mariko357/impulse/cad/impulse/symbols/3d/bmp280/Ekran görüntüsü 2021-03-28 230528.jpg

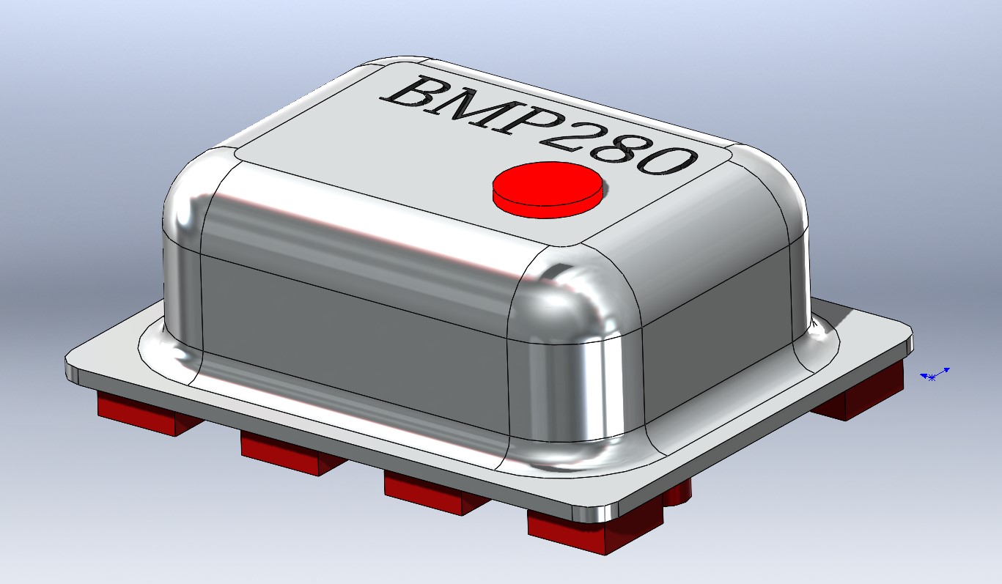
cad/impulse/symbols/3d/bmp280/Ekran görüntüsü 2021-03-28 230528.jpg
