mariko357/impulse/cad/impulse/symbols/3d/bmp280/BMP.jpg

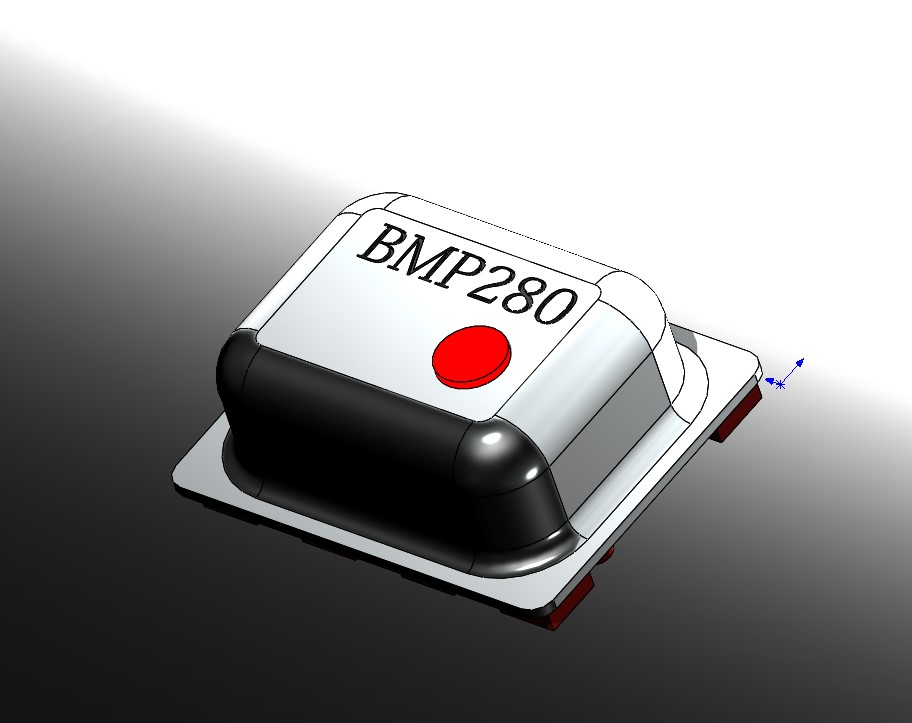
cad/impulse/symbols/3d/bmp280/BMP.jpg
