mariko357/impulse/readme.md

# Impulse
***
## Todo:
- [ ] Create a propper readme, I guess.
