mariko357/impulse/cad/impulse/symbols/3d/bmp280/BMP 280.STEP

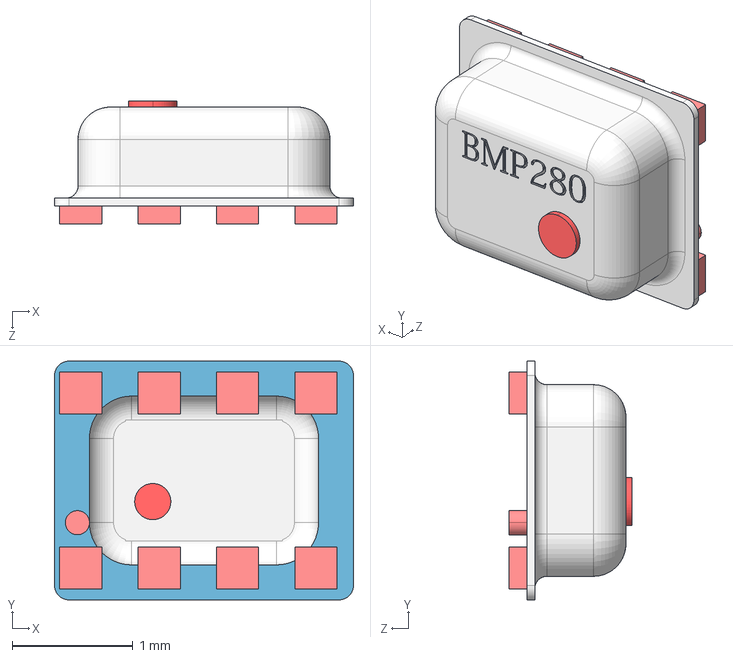
[picture p3: CAD file, 2023-07-16]
cad/impulse/symbols/3d/bmp280/BMP 280.STEP
2.48 x 1.98 x 1.02 mm
