mariko357/impulse/cad/impulse/symbols/bmi270/BMI270.step

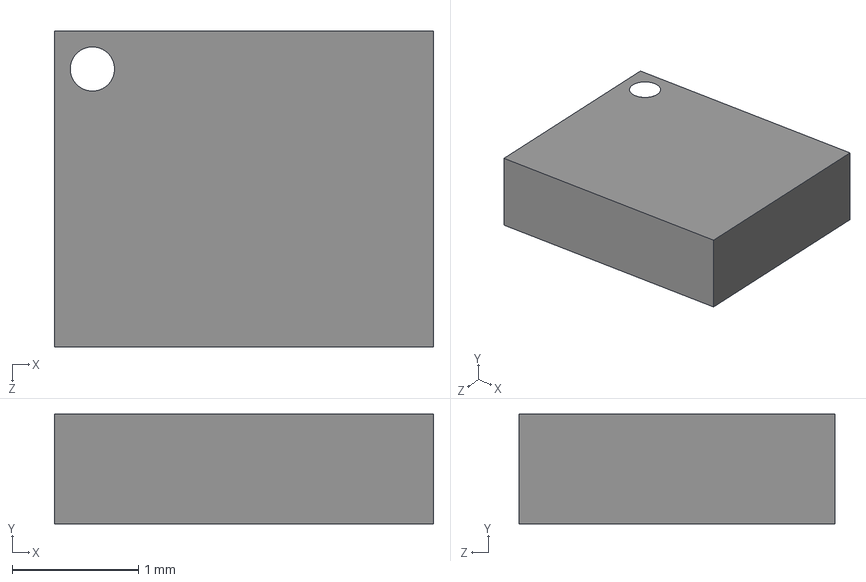
[picture p5: CAD file, 2023-05-13]
cad/impulse/symbols/bmi270/BMI270.step
3.00 x 0.87 x 2.50 mm
