mariko357/impulse/cad/impulse/impulse.kicad_pcb

## KiCad design cad/impulse/impulse.kicad_pcb (2023-07-16)

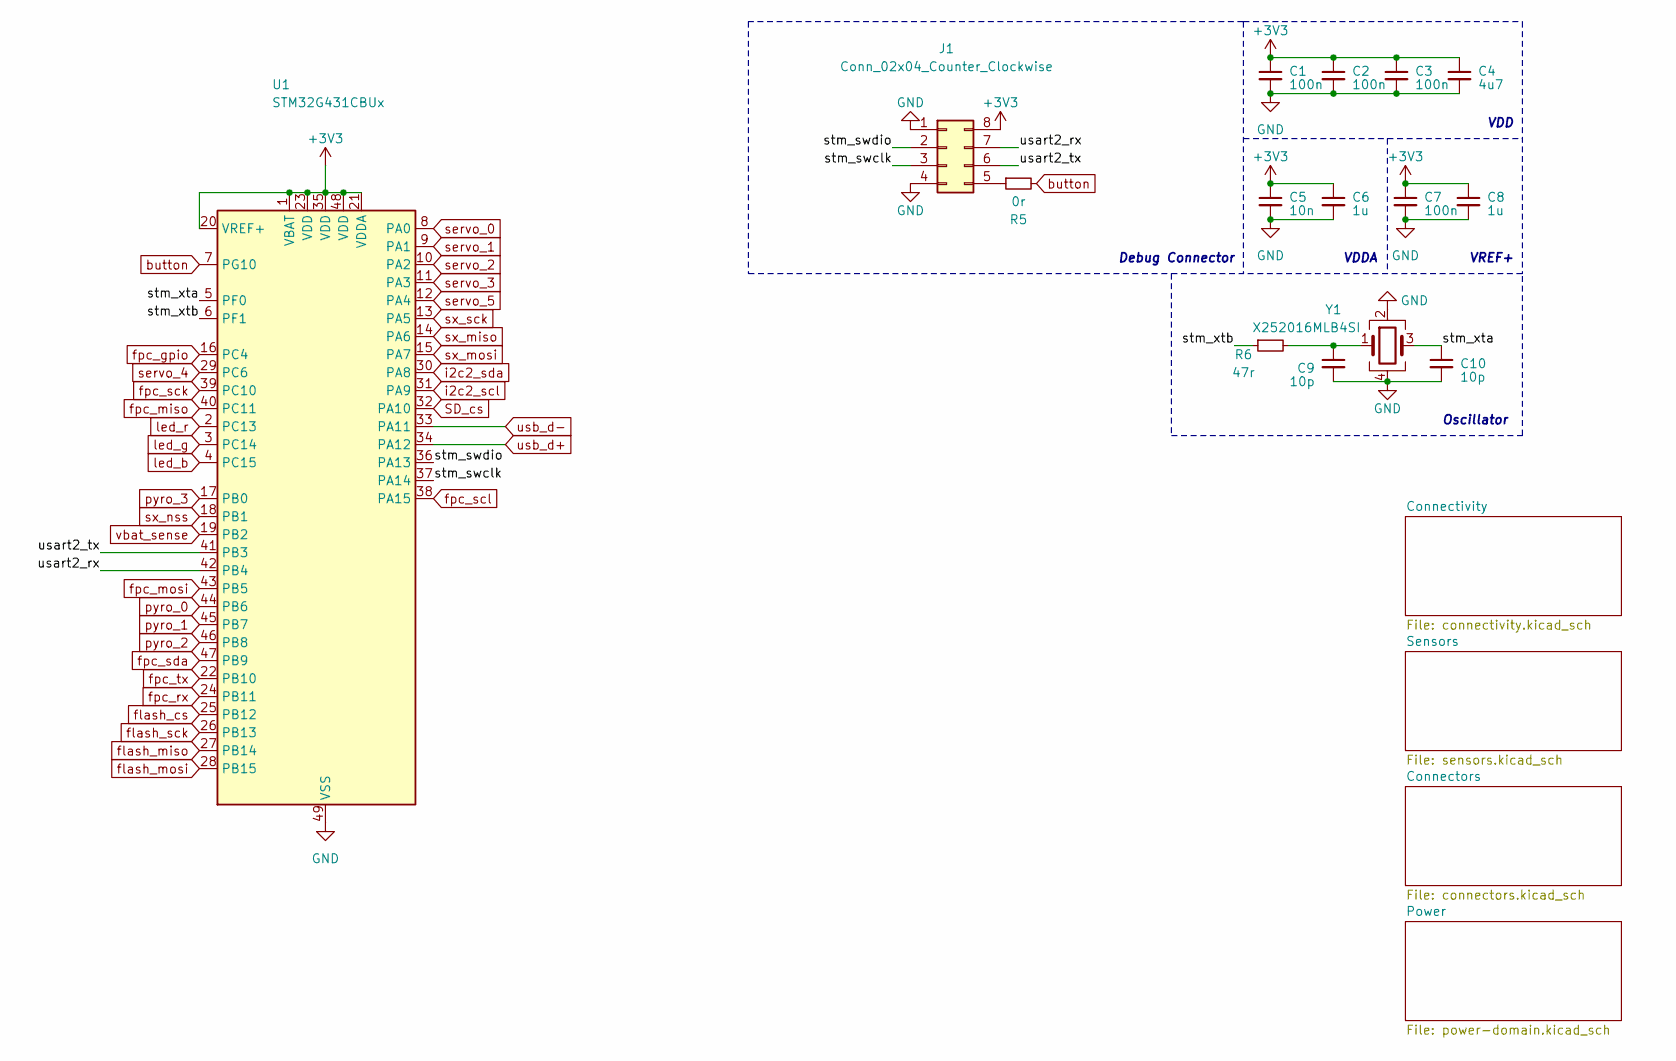
[picture p6: schematic impulse.kicad_sch, MCU]

Parts:
C1, C2, C3, C7: 100n; C_0402_1005Metric; lcsc C1525
C4: 4u7; C_0603_1608Metric; lcsc C5360855
C5: 10n; C_0603_1608Metric; lcsc C525264
C6, C8: 1u; C_0603_1608Metric; lcsc C167338
C9, C10: 10p; C_0402_1005Metric; lcsc C1545
J1: Conn_02x04_Counter_Clockwise; PinHeader_2x04_P1.27mm_Vertical_SMD; lcsc C2685182
R5: 0r; R_0402_1005Metric; lcsc C21376
R6: 47r; R_0402_1005Metric; lcsc C2906947
U1: STM32G431CBUx; QFN-48-1EP_7x7mm_P0.5mm_EP5.6x5.6mm; lcsc C529356
Y1: X252016MLB4SI; Crystal_SMD_2520-4Pin_2.5x2.0mm; lcsc C784073

Connections:
+3V3: C1.1, C2.1, C3.1, C4.1, C5.1, C6.1, C7.1, C8.1, J1.8, U1.1 (VBAT), U1.20 (VREF+), U1.21 (VDDA), U1.23 (VDD), U1.35 (VDD), U1.48 (VDD); also elsewhere on the board
/stm_swclk: J1.3, U1.37 (PA14)
/stm_swdio: J1.2, U1.36 (PA13)
/stm_xta: C10.1, U1.5 (PF0), Y1.3
/stm_xtb: R6.1, U1.6 (PF1)
/usart2_rx: J1.7, U1.42 (PB4)
/usart2_tx: J1.6, U1.41 (PB3)
GND: C1.2, C2.2, C3.2, C4.2, C5.2, C6.2, C7.2, C8.2, C9.2, C10.2, J1.1, J1.4, U1.49 (VSS), Y1.2, Y1.4; also elsewhere on the board
unnamed: C9.1, R6.2, Y1.1
unnamed: J1.5, R5.1
SD_cs: U1.32 (PA10); also elsewhere on the board
button: R5.2, U1.7 (PG10); also elsewhere on the board
flash_cs: U1.25 (PB12); also elsewhere on the board
flash_miso: U1.27 (PB14); also elsewhere on the board
flash_mosi: U1.28 (PB15); also elsewhere on the board
flash_sck: U1.26 (PB13); also elsewhere on the board
fpc_gpio: U1.16 (PC4); also elsewhere on the board
fpc_miso: U1.40 (PC11); also elsewhere on the board
fpc_mosi: U1.43 (PB5); also elsewhere on the board
fpc_rx: U1.24 (PB11); also elsewhere on the board
fpc_sck: U1.39 (PC10); also elsewhere on the board
fpc_tx: U1.22 (PB10); also elsewhere on the board
led_b: U1.4 (PC15); also elsewhere on the board
led_g: U1.3 (PC14); also elsewhere on the board
led_r: U1.2 (PC13); also elsewhere on the board
pyro_0: U1.44 (PB6); also elsewhere on the board
pyro_1: U1.45 (PB7); also elsewhere on the board
pyro_2: U1.46 (PB8); also elsewhere on the board
pyro_3: U1.17 (PB0); also elsewhere on the board
servo_0: U1.8 (PA0); also elsewhere on the board
servo_1: U1.9 (PA1); also elsewhere on the board
servo_2: U1.10 (PA2); also elsewhere on the board
servo_3: U1.11 (PA3); also elsewhere on the board
servo_4: U1.29 (PC6); also elsewhere on the board
servo_5: U1.12 (PA4); also elsewhere on the board
sx_miso: U1.14 (PA6); also elsewhere on the board
sx_mosi: U1.15 (PA7); also elsewhere on the board
sx_nss: U1.18 (PB1); also elsewhere on the board
sx_sck: U1.13 (PA5); also elsewhere on the board
usb_d+: U1.34 (PA12); also elsewhere on the board
usb_d-: U1.33 (PA11); also elsewhere on the board
vbat_sense: U1.19 (PB2); also elsewhere on the board

Notes on the sheet:
VREF+
VDD
Oscillator
Debug Connector
VDDA

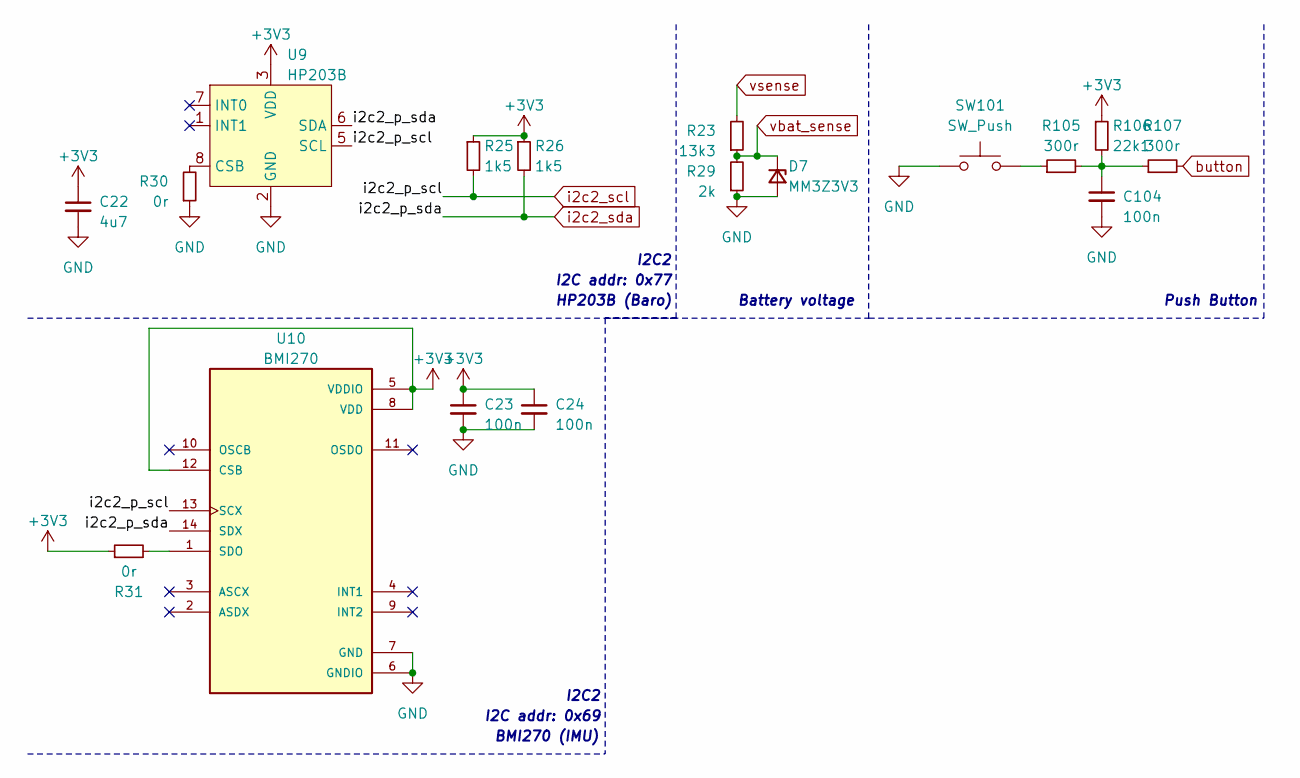
[picture p7: schematic sensors.kicad_sch]

Parts:
C22: 4u7; C_0603_1608Metric; lcsc C5360855
C23, C24, C104: 100n; C_0402_1005Metric; lcsc C1525
D7: MM3Z3V3; D_SOD-323; lcsc C2978809
R23: 13k3; R_0402_1005Metric; lcsc C3015832
R25, R26: 1k5; R_0402_1005Metric; lcsc C3017483
R29: 2k; R_0402_1005Metric; lcsc C3152076
R30, R31: 0r; R_0402_1005Metric; lcsc C21376
R105, R107: 300r; R_0402_1005Metric; lcsc C3017471
R106: 22k1; R_0402_1005Metric; lcsc C5356129
SW101: SW_Push; GT-TC029B-H025-L1N; lcsc C843669
U9: HP203B; QFN-8-P09; lcsc C138665
U10: BMI270; LGA-14_3x2.5mm_P0.5mm_LayoutBorder3x4y; lcsc C2836813

Connections:
+3V3: C22.1, C23.1, C24.1, R25.1, R26.1, R31.1, U9.3 (VDD), U10.5 (VDDIO), U10.8 (VDD), U10.12 (CSB); also elsewhere on the board
GND: C22.2, C23.2, C24.2, D7.2 (A), R29.1, R30.1, U9.2 (GND), U10.6 (GNDIO), U10.7 (GND); also elsewhere on the board
unnamed: R30.2, U9.8 (CSB)
unnamed: R31.2, U10.1 (SDO)
vbat_sense: D7.1 (K), R23.1, R29.2; also elsewhere on the board
vsense: R23.2; also elsewhere on the board

Notes on the sheet:
BMI270 (IMU)
I2C2
I2C addr: 0x69
HP203B (Baro)
Push Button
Battery voltage
I2C addr: 0x77

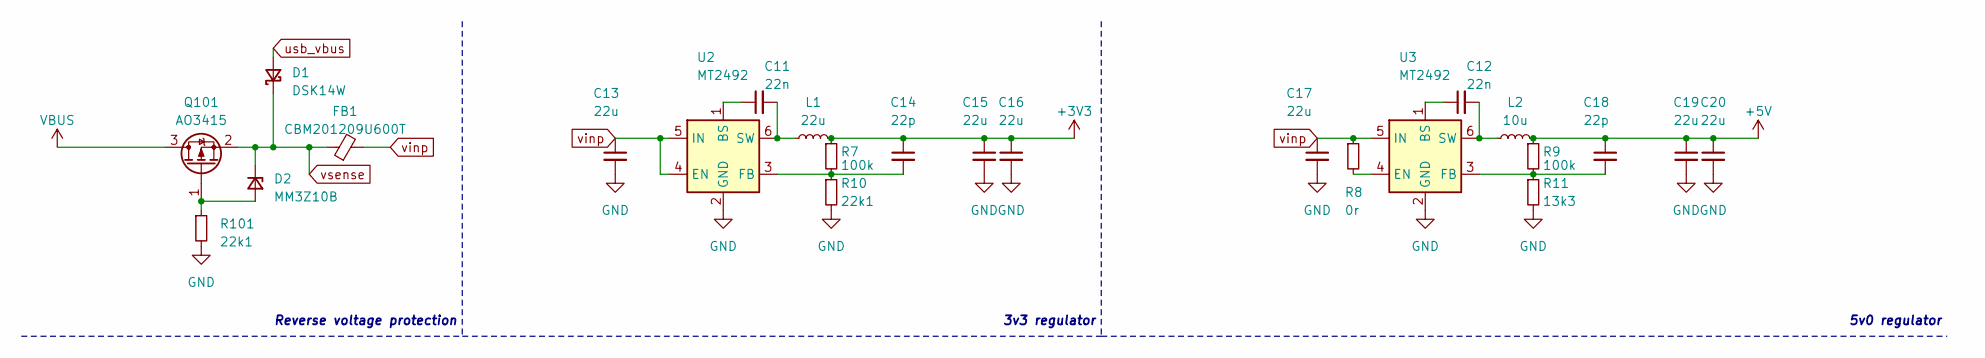
[picture p8: schematic power-domain.kicad_sch, Power]

Parts:
C11, C12: 22n; C_0402_1005Metric; lcsc C5137627
C13, C15, C16, C17, C19, C20: 22u; C_1206_3216Metric; lcsc C2858005
C14, C18: 22p; C_0402_1005Metric; lcsc C5137569
D1: DSK14W; D_SOD-123F; lcsc C3014043
D2: MM3Z10B; D_SOD-323; lcsc C2826565
FB1: CBM201209U600T; R_0805_2012Metric; lcsc C139167
L1: 22u; L_1210_3225Metric; lcsc C223225
L2: 10u; L_Sunlord_MWSA0402S; lcsc C2921170
Q101: AO3415; SOT-23; lcsc C181094
R7, R9: 100k; R_0402_1005Metric; lcsc C3017514
R8: 0r; R_0402_1005Metric; lcsc C21376
R10, R101: 22k1; R_0402_1005Metric; lcsc C5356129
R11: 13k3; R_0402_1005Metric; lcsc C3015832
U2, U3: MT2492; SOT-23-6; lcsc C89358

Connections:
+3V3: C14.1, C15.1, C16.1, L1.2, R7.1; also elsewhere on the board
+5V: C18.1, C19.1, C20.1, L2.2, R9.1; also elsewhere on the board
GND: C13.2, C15.2, C16.2, C17.2, C19.2, C20.2, R10.2, R11.2, U2.2 (GND), U3.2 (GND); also elsewhere on the board
unnamed 24: D2.2 (A); also elsewhere on the board
unnamed: C11.1, U2.1 (BS)
unnamed: C14.2, R7.2, R10.1, U2.3 (FB)
unnamed: C11.2, L1.1, U2.6 (SW)
unnamed: C12.1, U3.1 (BS)
unnamed: R8.2, U3.4 (EN)
unnamed: C18.2, R9.2, R11.1, U3.3 (FB)
unnamed: C12.2, L2.1, U3.6 (SW)
usb_vbus: D1.2 (A); also elsewhere on the board
vinp: C13.1, C17.1, FB1.2, R8.1, U2.4 (EN), U2.5 (IN), U3.5 (IN); also elsewhere on the board
vsense: D1.1 (K), D2.1 (K), FB1.1; also elsewhere on the board

Notes on the sheet:
5v0 regulator
3v3 regulator
Reverse voltage protection

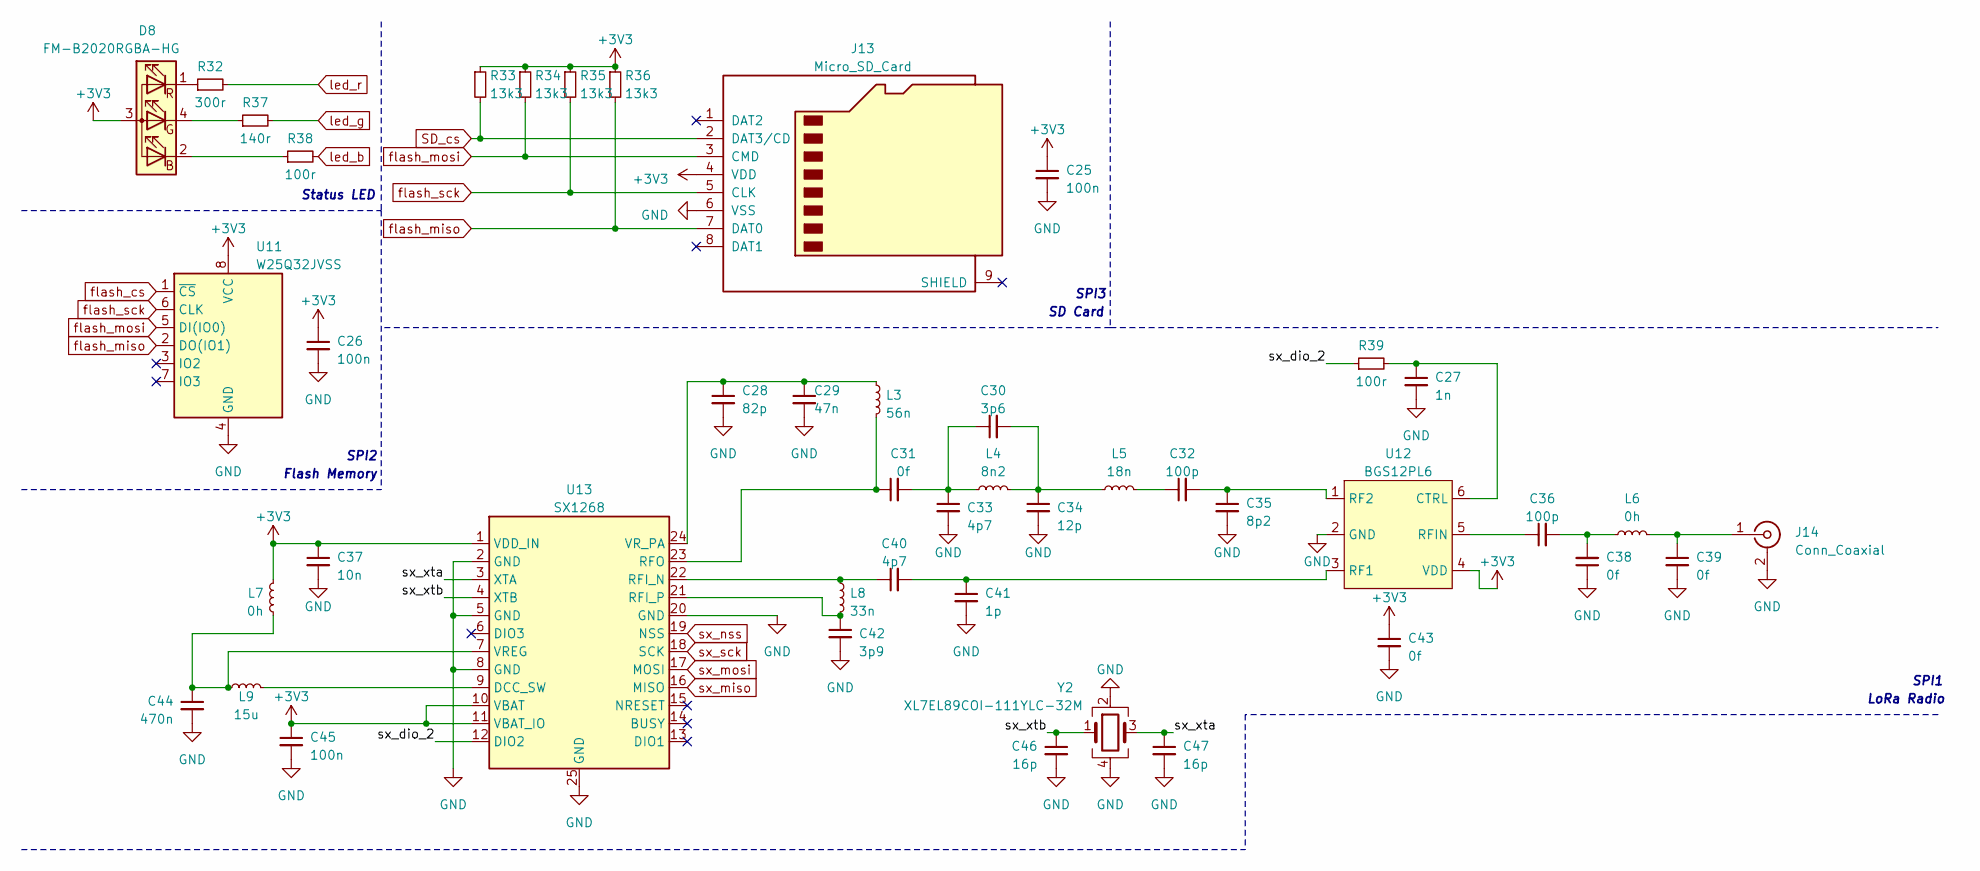
[picture p9: schematic connectivity.kicad_sch]

Parts:
C25, C26, C45: 100n; C_0402_1005Metric; lcsc C1525
C27: 1n; C_0201_0603Metric; lcsc C301889
C28: 82p; C_0201_0603Metric; lcsc C285023
C29: 47n; C_0201_0603Metric; lcsc C513424
C30: 3p6; C_0201_0603Metric; lcsc C525056
C31, C38, C39, C43: 0f; C_0201_0603Metric; lcsc C3152011
C32, C36: 100p; C_0201_0603Metric; lcsc C5142539
C33, C40: 4p7; C_0201_0603Metric; lcsc C525057
C34: 12p; C_0201_0603Metric; lcsc C50391
C35: 8p2; C_0201_0603Metric; lcsc C913427
C37: 10n; C_0603_1608Metric; lcsc C525264
C41: 1p; C_0201_0603Metric; lcsc C285009
C42: 3p9; C_0201_0603Metric; lcsc C285000
C44: 470n; C_0402_1005Metric; lcsc C5142573
C46, C47: 16p; C_0402_1005Metric; lcsc C5142569
D8: FM-B2020RGBA-HG; lcsc C108793
J13: Micro_SD_Card; microSD-Generic; lcsc C393941
J14: Conn_Coaxial; U.FL_Hirose_U.FL-R-SMT-1_Vertical; lcsc C5299419
L3: 56n; L_0201_0603Metric; lcsc C963966
L4: 8n2; L_0201_0603Metric; lcsc C2941401
L5: 18n; L_0201_0603Metric; lcsc C2913989
L6: 0h; L_0201_0603Metric; lcsc C3152011
L7: 0h; L_0402_1005Metric; lcsc C21376
L8: 33n; L_0201_0603Metric; lcsc C211337
L9: 15u; L_0805_2012Metric; lcsc C383402
R32: 300r; R_0402_1005Metric; lcsc C3017471
R33, R34, R35, R36: 13k3; R_0402_1005Metric; lcsc C3015832
R37: 140r; R_0402_1005Metric; lcsc C3015963
R38, R39: 100r; R_0402_1005Metric; lcsc C3152058
U11: W25Q32JVSS; SOIC-8_5.23x5.23mm_P1.27mm; lcsc C2834491
U12: BGS12PL6; lcsc C2939943
U13: SX1268; QFN-24-1EP_4x4mm_P0.5mm_EP2.7x2.7mm; lcsc C244368
Y2: XL7EL89COI-111YLC-32M; Crystal_SMD_2016-4Pin_2.0x1.6mm; lcsc C2965584

Connections:
+3V3: C25.1, C26.1, C37.1, C43.1, C45.1, D8.3 (A), J13.4 (VDD), L7.1, R33.1, R34.1, R35.1, R36.1, U11.8 (VCC), U12.4 (VDD), U13.1 (VDD_IN), U13.10 (VBAT), U13.11 (VBAT_IO); also elsewhere on the board
/Connectivity/sx_dio_2: R39.1, U13.12 (DIO2)
/Connectivity/sx_xta: C47.1, U13.3 (XTA), Y2.3
/Connectivity/sx_xtb: C46.1, U13.4 (XTB), Y2.1
GND: C25.2, C26.2, C27.2, C28.2, C29.2, C33.2, C34.2, C35.2, C37.2, C38.1, C39.2, C41.2, C42.2, C43.2, C44.2, C45.2, C46.2, C47.2, J13.6 (VSS), J14.2 (Ext), U11.4 (GND), U12.2 (GND), U13.2 (GND), U13.5 (GND), U13.8 (GND), U13.20 (GND), U13.25 (GND), Y2.2, Y2.4; also elsewhere on the board
unnamed: C30.1, C31.2, C33.1, L4.1
unnamed: C30.2, C34.1, L4.2, L5.1
unnamed: C32.1, L5.2
unnamed: C36.2, C38.2, L6.1
unnamed: D8.2 (BK), R38.1
unnamed: D8.4 (GK), R37.1
unnamed: D8.1 (RK), R32.1
unnamed: C39.1, J14.1 (In), L6.2
unnamed: C27.1, R39.2, U12.6 (CTRL)
unnamed: C40.2, C41.1, U12.3 (RF1)
unnamed: C32.2, C35.1, U12.1 (RF2)
unnamed: C36.1, U12.5 (RFIN)
unnamed: L9.2, U13.9 (DCC_SW)
unnamed: C40.1, L8.1, U13.22 (RFI_N)
unnamed: C42.1, L8.2, U13.21 (RFI_P)
unnamed: C31.1, L3.2, U13.23 (RFO)
unnamed: C44.1, L7.2, L9.1, U13.7 (VREG)
unnamed: C28.1, C29.1, L3.1, U13.24 (VR_PA)
SD_cs: J13.2 (DAT3/CD), R33.2; also elsewhere on the board
flash_cs: U11.1 (~CS); also elsewhere on the board
flash_miso: J13.7 (DAT0), R36.2, U11.2 (DO(IO1)); also elsewhere on the board
flash_mosi: J13.3 (CMD), R34.2, U11.5 (DI(IO0)); also elsewhere on the board
flash_sck: J13.5 (CLK), R35.2, U11.6 (CLK); also elsewhere on the board
led_b: R38.2; also elsewhere on the board
led_g: R37.2; also elsewhere on the board
led_r: R32.2; also elsewhere on the board
sx_miso: U13.16 (MISO); also elsewhere on the board
sx_mosi: U13.17 (MOSI); also elsewhere on the board
sx_nss: U13.19 (NSS); also elsewhere on the board
sx_sck: U13.18 (SCK); also elsewhere on the board

Notes on the sheet:
SPI2
SPI3
LoRa Radio
Status LED
SPI1
Flash Memory
SD Card

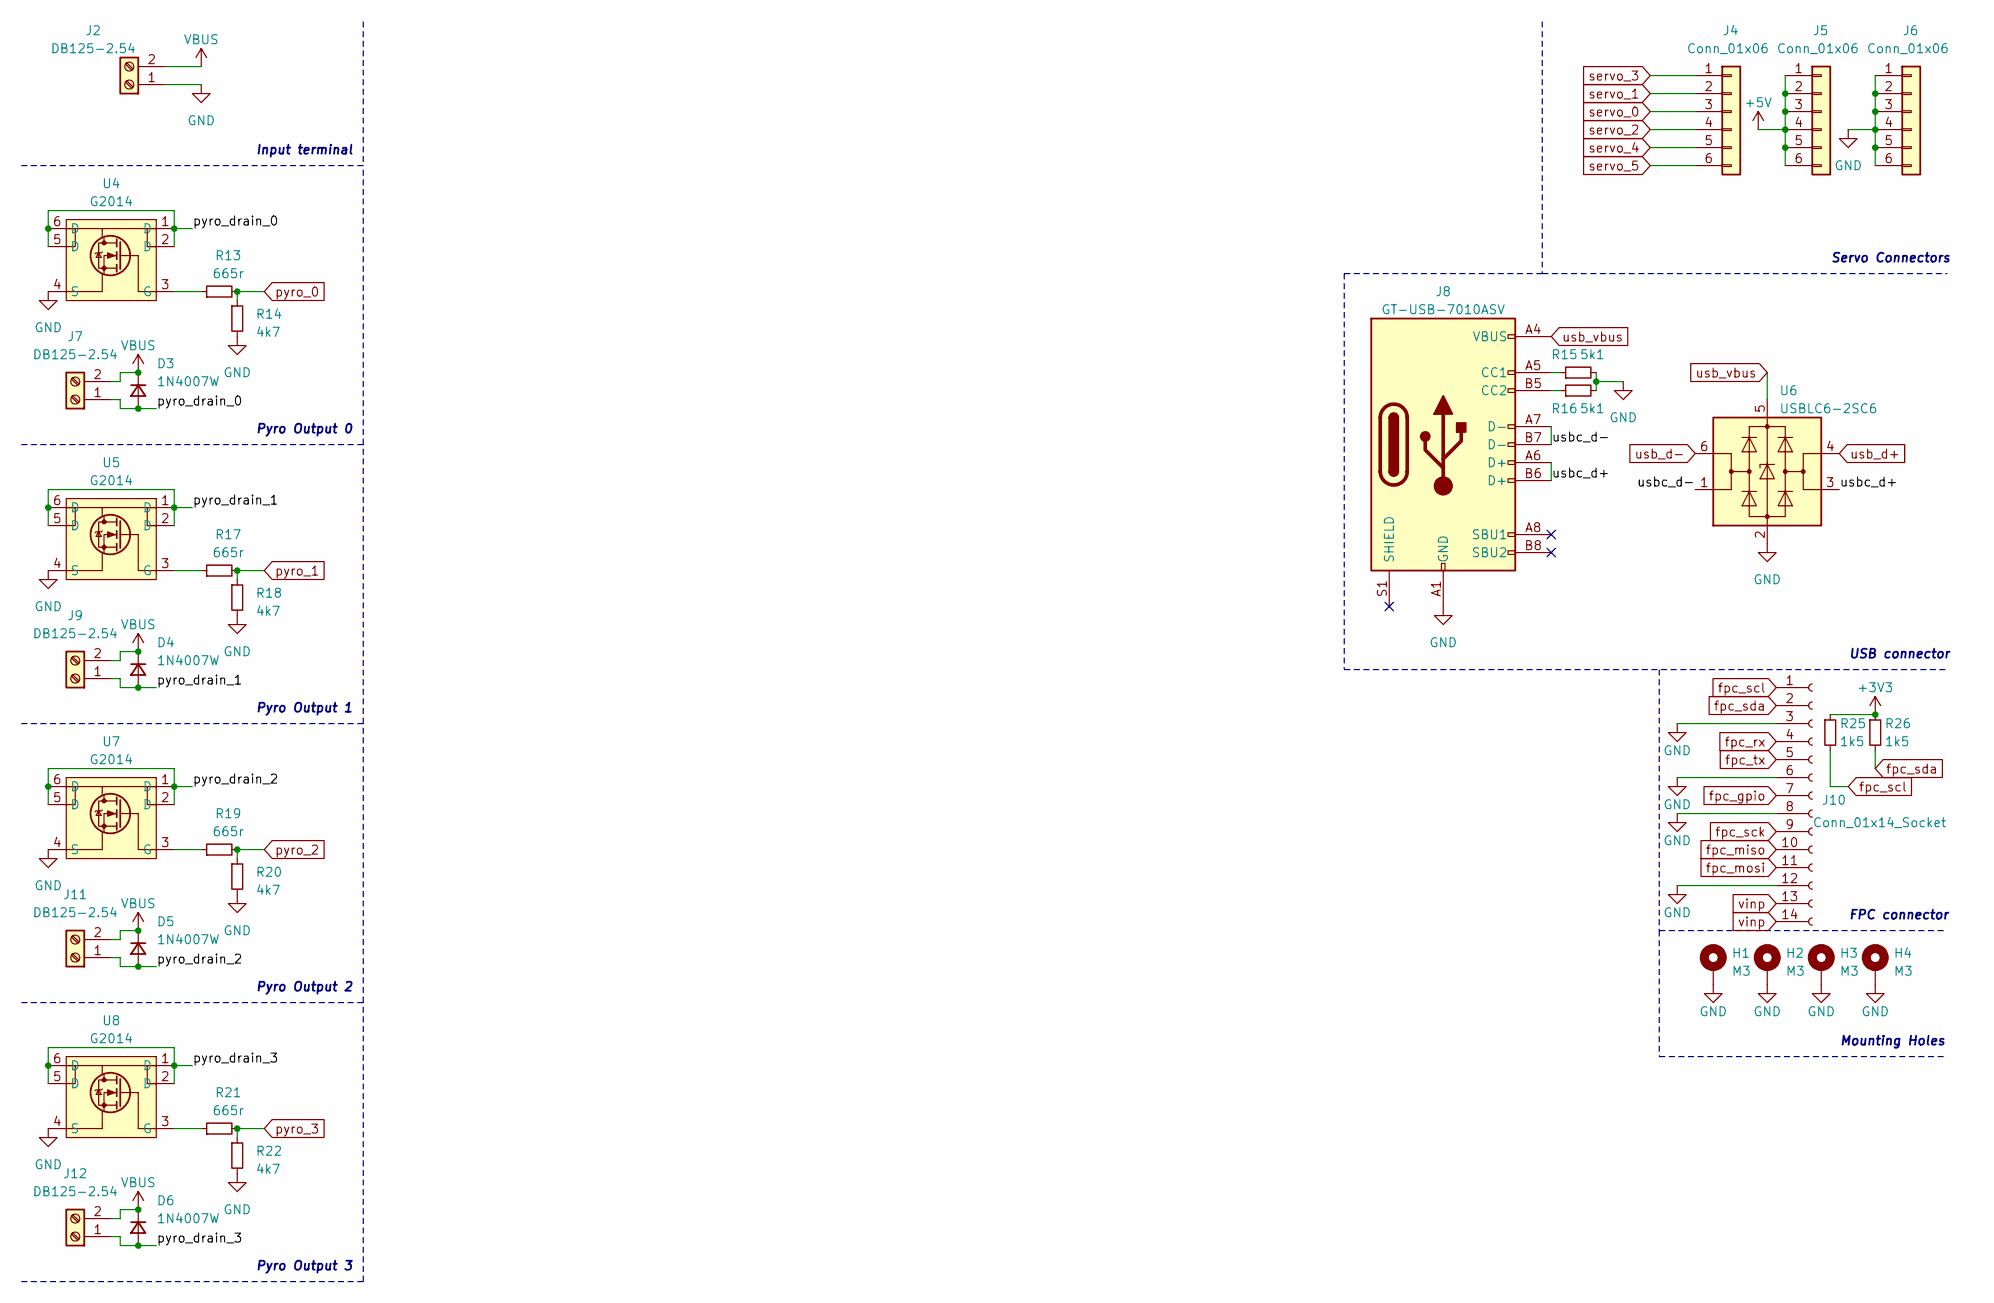
[picture p10: schematic connectors.kicad_sch]

Parts:
D3, D4, D5, D6: 1N4007W; D_SOD-123F; lcsc C727082
H1, H2, H3, H4: M3; MountingHole_3.2mm_M3_Pad_Via
J2: DB125-2.54; TerminalBlock_TE_282834-2_1x02_P2.54mm_Horizontal; lcsc C918120
J4, J5, J6: Conn_01x06; PinHeader_1x06_P2.54mm_Vertical
J7, J9, J11, J12: DB125-2.54; TerminalBlock_TE_282834-2_1x02_P2.54mm_Horizontal; lcsc C918126
J8: GT-USB-7010ASV; USB_C_Receptacle_G-Switch_GT-USB-7010ASV; lcsc C2988369
J10: Conn_01x14_Socket; Hirose_FH12-14S-0.5SH_1x14-1MP_P0.50mm_Horizontal; lcsc C2856800
R13, R17, R19, R21: 665r; R_0402_1005Metric; lcsc C3015970
R14, R18, R20, R22: 4k7; R_0402_1005Metric; lcsc C103059
R15, R16: 5k1; R_0402_1005Metric; lcsc C3152095
R25, R26: 1k5; R_0402_1005Metric; lcsc C3017483
U4, U5, U7, U8: G2014; DFN-6-L; lcsc C3038579
U6: USBLC6-2SC6; SOT-23-6; lcsc C558442

Connections:
+3V3: R25.1, R26.1; also elsewhere on the board
+5V: J5.1, J5.2, J5.3, J5.4, J5.5, J5.6; also elsewhere on the board
/Connectors/pyro_drain_0: D3.2 (A), J7.1, U4.1 (D), U4.2 (D), U4.5 (D), U4.6 (D)
/Connectors/pyro_drain_1: D4.2 (A), J9.1, U5.1 (D), U5.2 (D), U5.5 (D), U5.6 (D)
/Connectors/pyro_drain_2: D5.2 (A), J11.1, U7.1 (D), U7.2 (D), U7.5 (D), U7.6 (D)
/Connectors/pyro_drain_3: D6.2 (A), J12.1, U8.1 (D), U8.2 (D), U8.5 (D), U8.6 (D)
/Connectors/usbc_d+: J8.A6 (D+), J8.B6 (D+), U6.3 (I/O2)
/Connectors/usbc_d-: J8.A7 (D-), J8.B7 (D-), U6.1 (I/O1)
GND: H1.1, H2.1, H3.1, H4.1, J2.1, J6.1, J6.2, J6.3, J6.4, J6.5, J6.6, J8.A1 (GND), J8.A12 (GND), J8.B1 (GND), J8.B12 (GND), J10.3, J10.6, J10.8, J10.12, R14.2, R15.2, R16.2, R18.2, R20.2, R22.2, U4.4 (S), U5.4 (S), U6.2 (GND), U7.4 (S), U8.4 (S); also elsewhere on the board
unnamed: J8.A5 (CC1), R15.1
unnamed: J8.B5 (CC2), R16.1
unnamed: R13.1, U4.3 (G)
unnamed: R17.1, U5.3 (G)
unnamed: R19.1, U7.3 (G)
unnamed: R21.1, U8.3 (G)
VBUS: D3.1 (K), D4.1 (K), D5.1 (K), D6.1 (K), J2.2, J7.2, J9.2, J11.2, J12.2; also elsewhere on the board
fpc_gpio: J10.7; also elsewhere on the board
fpc_miso: J10.10; also elsewhere on the board
fpc_mosi: J10.11; also elsewhere on the board
fpc_rx: J10.4; also elsewhere on the board
fpc_sck: J10.9; also elsewhere on the board
fpc_tx: J10.5; also elsewhere on the board
pyro_0: R13.2, R14.1; also elsewhere on the board
pyro_1: R17.2, R18.1; also elsewhere on the board
pyro_2: R19.2, R20.1; also elsewhere on the board
pyro_3: R21.2, R22.1; also elsewhere on the board
servo_0: J4.3; also elsewhere on the board
servo_1: J4.2; also elsewhere on the board
servo_2: J4.4; also elsewhere on the board
servo_3: J4.1; also elsewhere on the board
servo_4: J4.5; also elsewhere on the board
servo_5: J4.6; also elsewhere on the board
usb_d+: U6.4 (I/O2); also elsewhere on the board
usb_d-: U6.6 (I/O1); also elsewhere on the board
usb_vbus: J8.A4 (VBUS), J8.A9 (VBUS), J8.B4 (VBUS), J8.B9 (VBUS), U6.5 (VBUS); also elsewhere on the board
vinp: J10.13, J10.14; also elsewhere on the board

Notes on the sheet:
Pyro Output 1
Pyro Output 0
FPC connector
Pyro Output 3
USB connector
Pyro Output 2
Mounting Holes
Input terminal
Servo Connectors

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
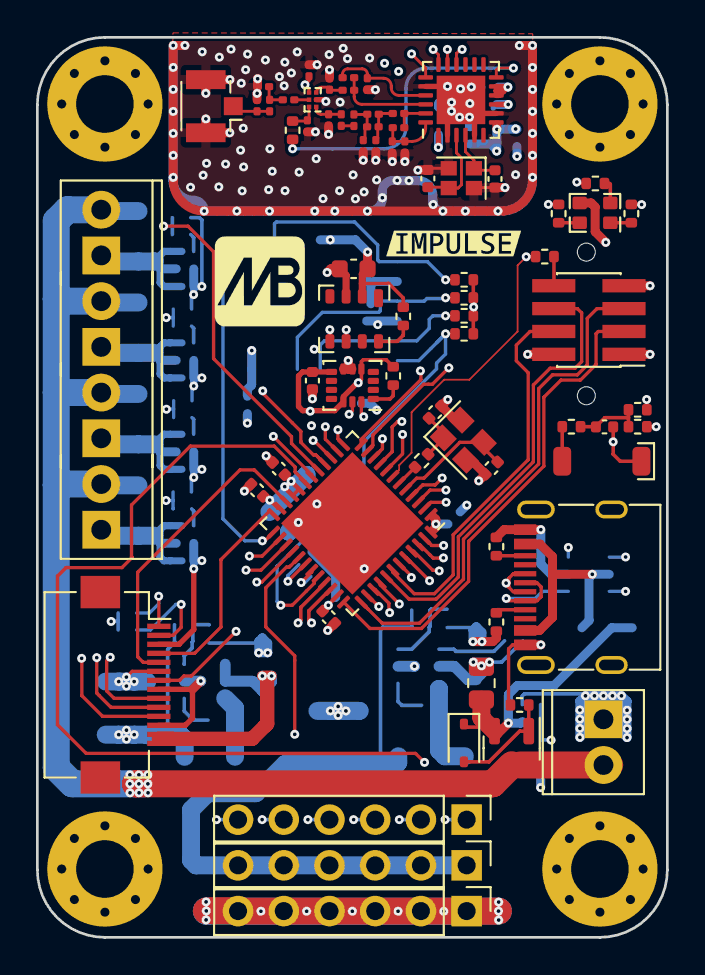
[picture p11: board impulse.kicad_pcb from above]

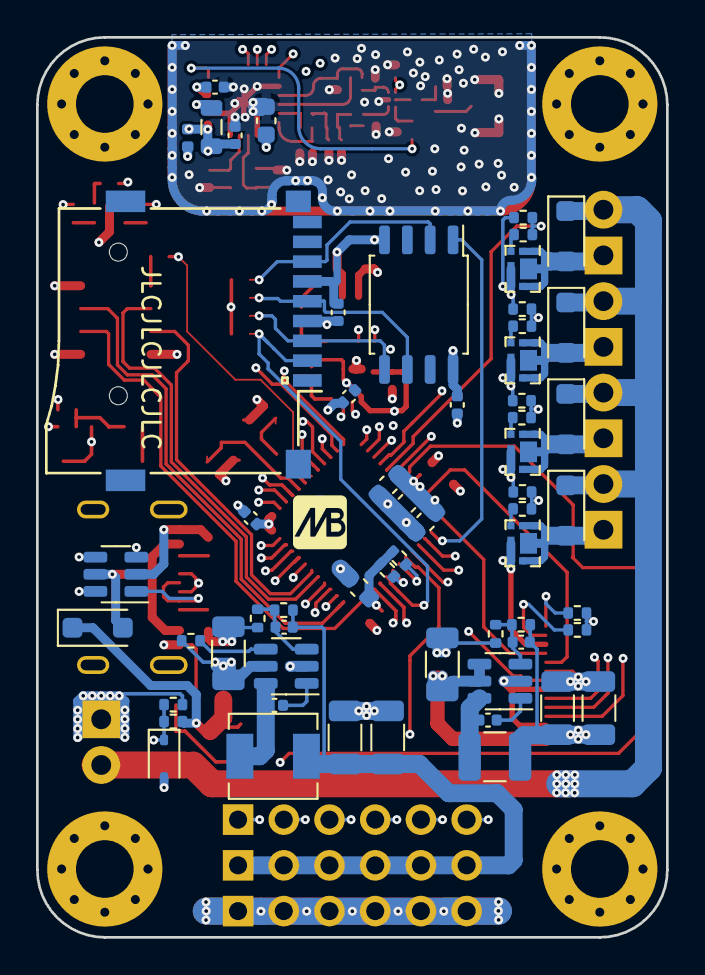
[picture p12: board impulse.kicad_pcb from below]

Board: 8 copper layers, 35.0 x 50.0 mm, 137 parts (59 on the bottom side), 96 nets.

Other parts of the board:
C21: 100n; C_0402_1005Metric
Q1: AO3415; SOT-23
R1, R2: 1k5; R_0402_1005Metric
R12, R24: 22k1; R_0402_1005Metric
R27, R28: 300r; R_0402_1005Metric
SW1: SW_Push; GT-TC029B-H025-L1N
kibuzzard-647A5142: G***; kibuzzard-647A5142

Their connections:
+3V3: R1.1, R2.1, R24.1; also elsewhere on the board
GND: C21.2, R12.2, SW1.1; also elsewhere on the board
unnamed: C21.1, R24.2, R27.2, R28.1
unnamed 24: Q1.1 (G), R12.1; also elsewhere on the board
unnamed: R27.1, SW1.2
VBUS: Q1.3 (D); also elsewhere on the board
button: R28.2; also elsewhere on the board
vsense: Q1.2 (S); also elsewhere on the board
