mariko357/impulse/(commit log)

2023-05-08 Added pyro channels and power domain.
    [connectors.kicad_sch, power-domain.kicad_sch, zenith.kicad_pcb, zenith.kicad_sch]
2023-05-11 Changed the power domain to mt2492.
    [connectors.kicad_sch, impulse.kicad_pcb, impulse.kicad_sch, power-domain.kicad_sch]
2023-05-11 Calculated smps values and modified .gitignore.
    [power-domain.kicad_sch]
2023-05-12 Started Working on sensors. Made connectors for servos.
    [connectors.kicad_sch, impulse.kicad_sch, sensors.kicad_sch]
2023-05-13 Added IMU, button and led. Moved things around.
    [BMI270.step, connectivity.kicad_sch, connectors.kicad_sch, impulse.kicad_sch, power-domain.kicad_sch, sensors.kicad_sch]
2023-05-13 Transitioned to global labels when needed.
    [connectivity.kicad_sch, connectors.kicad_sch, sensors.kicad_sch]
2023-05-13 Added USB connector.
    [connectors.kicad_sch, power-domain.kicad_sch]
2023-05-16 Finished with LoRa.
    [connectivity.kicad_sch, connectors.kicad_sch, power-domain.kicad_sch, sensors.kicad_sch]
2023-05-18 Finnished the design.
    [connectivity.kicad_sch, connectors.kicad_sch, impulse.kicad_sch, power-domain.kicad_sch, sensors.kicad_sch]
2023-05-19 Started working on BOM, did consolidation.
    [connectivity.kicad_sch, connectors.kicad_sch, impulse.kicad_sch, power-domain.kicad_sch, sensors.kicad_sch]
2023-05-21 Finished with schematic, starting to route traces.
    [connectivity.kicad_sch, connectors.kicad_sch, impulse.kicad_pcb, impulse.kicad_sch, power-domain.kicad_sch, sensors.kicad_sch]
2023-05-21 Modified oscillator circuit.
    [connectivity.kicad_sch, connectors.kicad_sch, impulse.kicad_pcb, impulse.kicad_sch, power-domain.kicad_sch, sensors.kicad_sch]
2023-05-27 First layout.
    [connectivity.kicad_sch, connectors.kicad_sch, impulse.kicad_pcb, impulse.kicad_sch, power-domain.kicad_sch, sensors.kicad_sch]
2023-07-16 Final version, ordered it.
    [BMP 280.STEP, MicroSD_Socket.STEP, connectivity.kicad_sch, connectors.kicad_sch, impulse.kicad_pcb, impulse.kicad_sch, power-domain.kicad_sch]
2023-07-16 Ignoring bom folder now, added readme.
